MagnusThome/BMW-M2-DCT-Gear-indicator/(commit log)

2020-01-21 analog detect 12V from car to shut down requests when engine is off
2020-01-21 option to disable brownout
    [main.ino]
2021-12-09 Wrong pin corrected on SPI to MCP2515
    Wrong pin corrected on SPI to 2515, thx Dimitris :-)
2021-12-09 Corrected comment on edit of MCP2515
    Is GPIO26 not 27
    [main.ino]
2021-12-09 Corrected comment on edit of MCP2515
    Thx Dimitri!
    [bridge.ino]
